BradleyConn/bc_flight_computer/3D_Models/24mm_to_29mm_adapter.stl

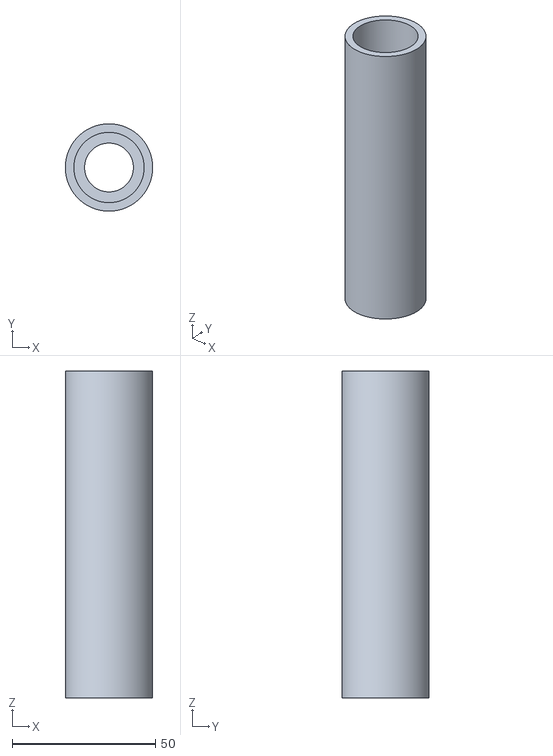
[picture p1: CAD file, 2024-02-27]
3D_Models/24mm_to_29mm_adapter.stl
30.4 x 30.4 x 114.0
