BradleyConn/bc_flight_computer/3D_Models/board_monut_board_slot_test.stl

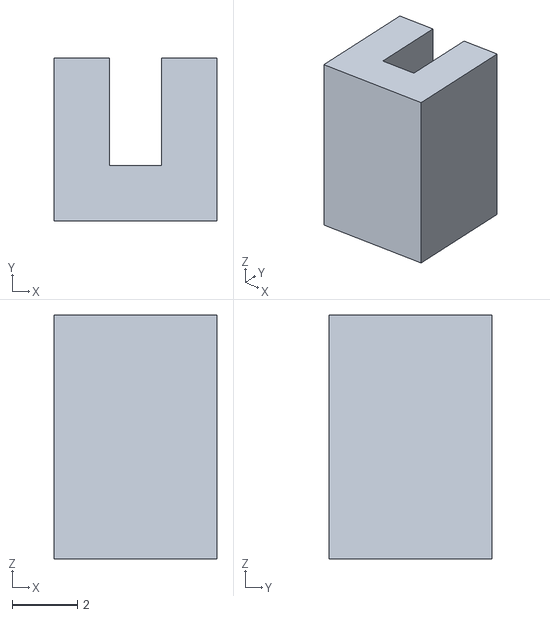
[picture p2: CAD file, 2024-02-27]
3D_Models/board_monut_board_slot_test.stl
5.00 x 5.00 x 7.50
