BradleyConn/bc_flight_computer/Hardware/KiCad/projects/rp2040_v0/rp2040_v0/gerbers_v0.pdf

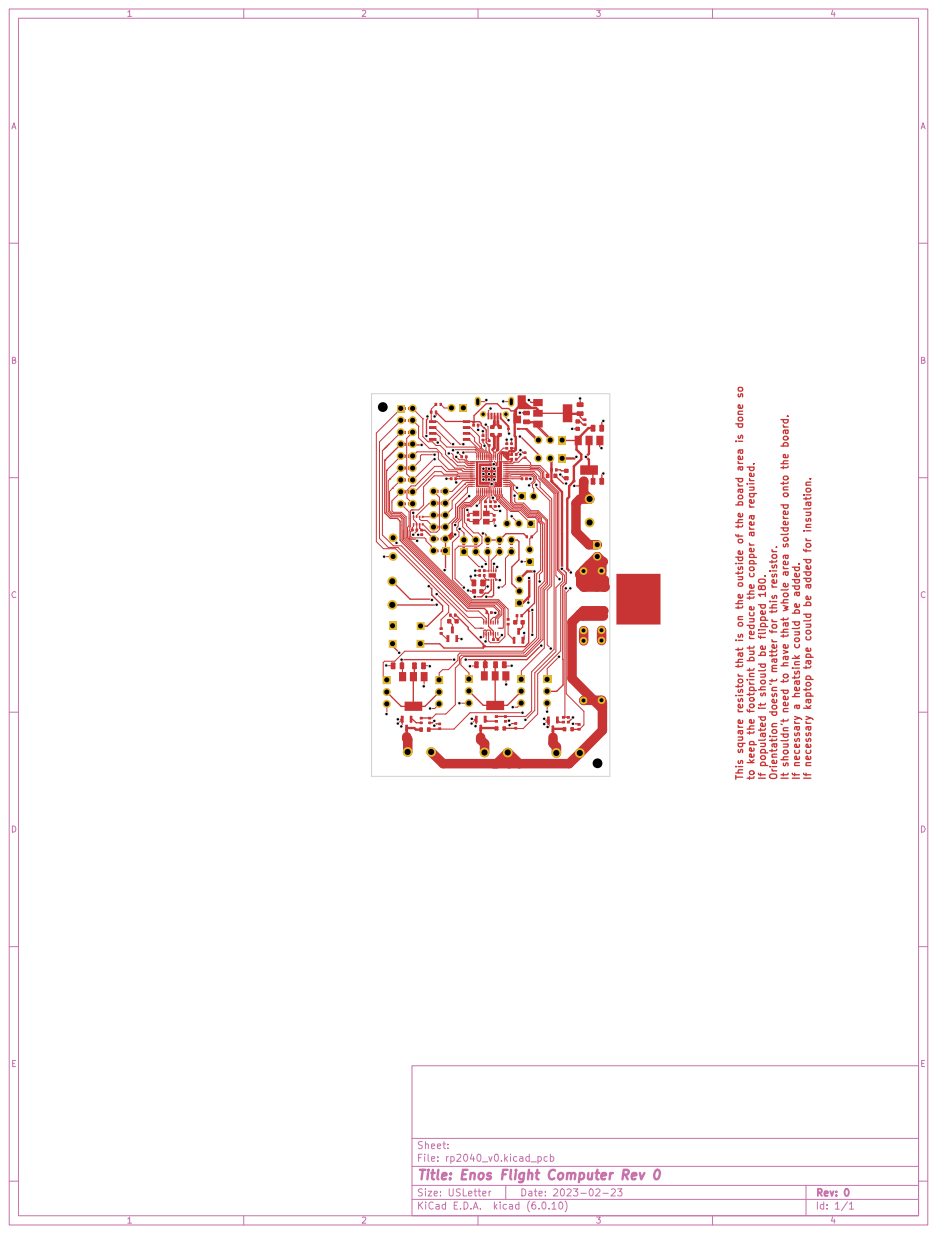
[picture p3: page 1]

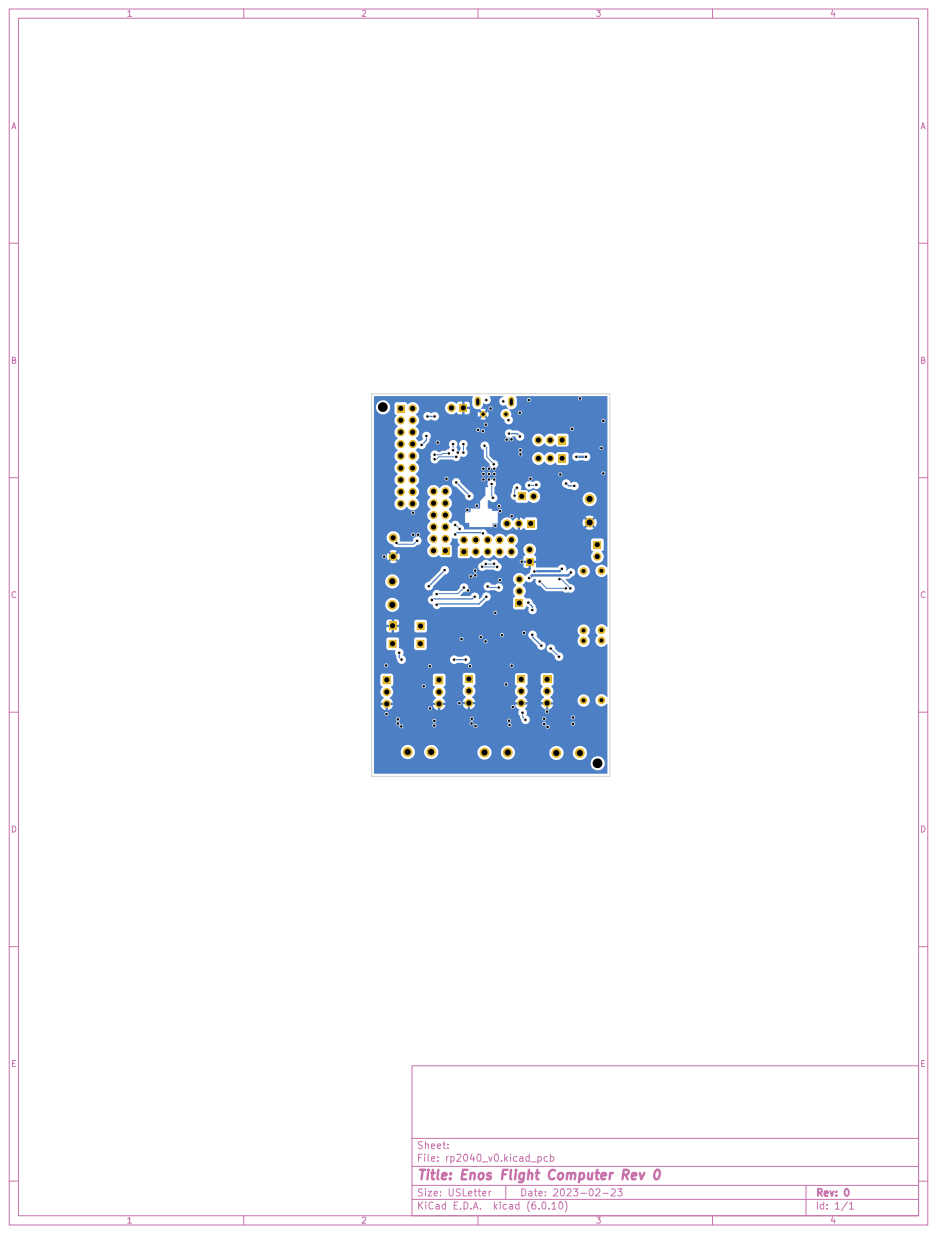
[picture p4: page 2]

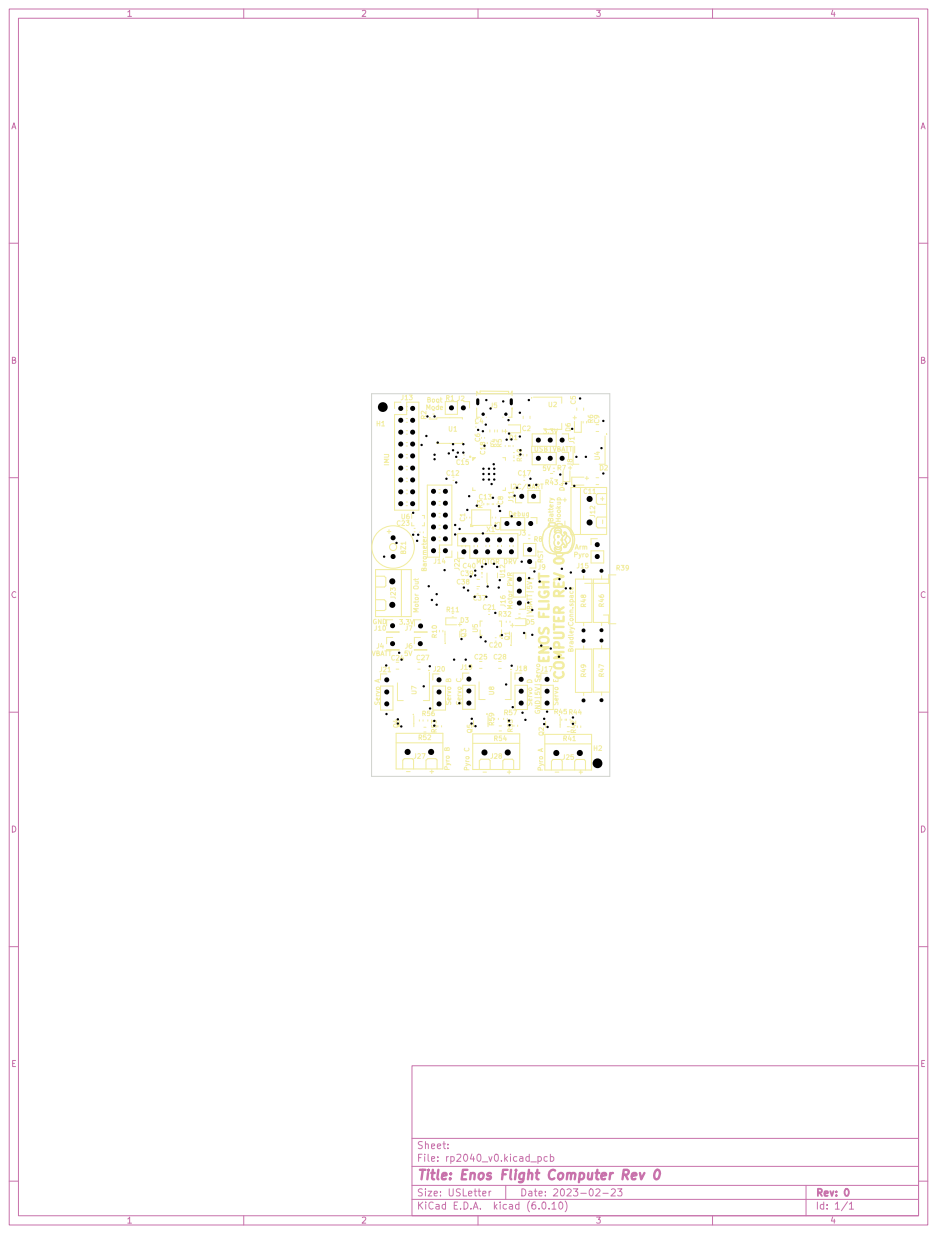
[picture p5: page 3]

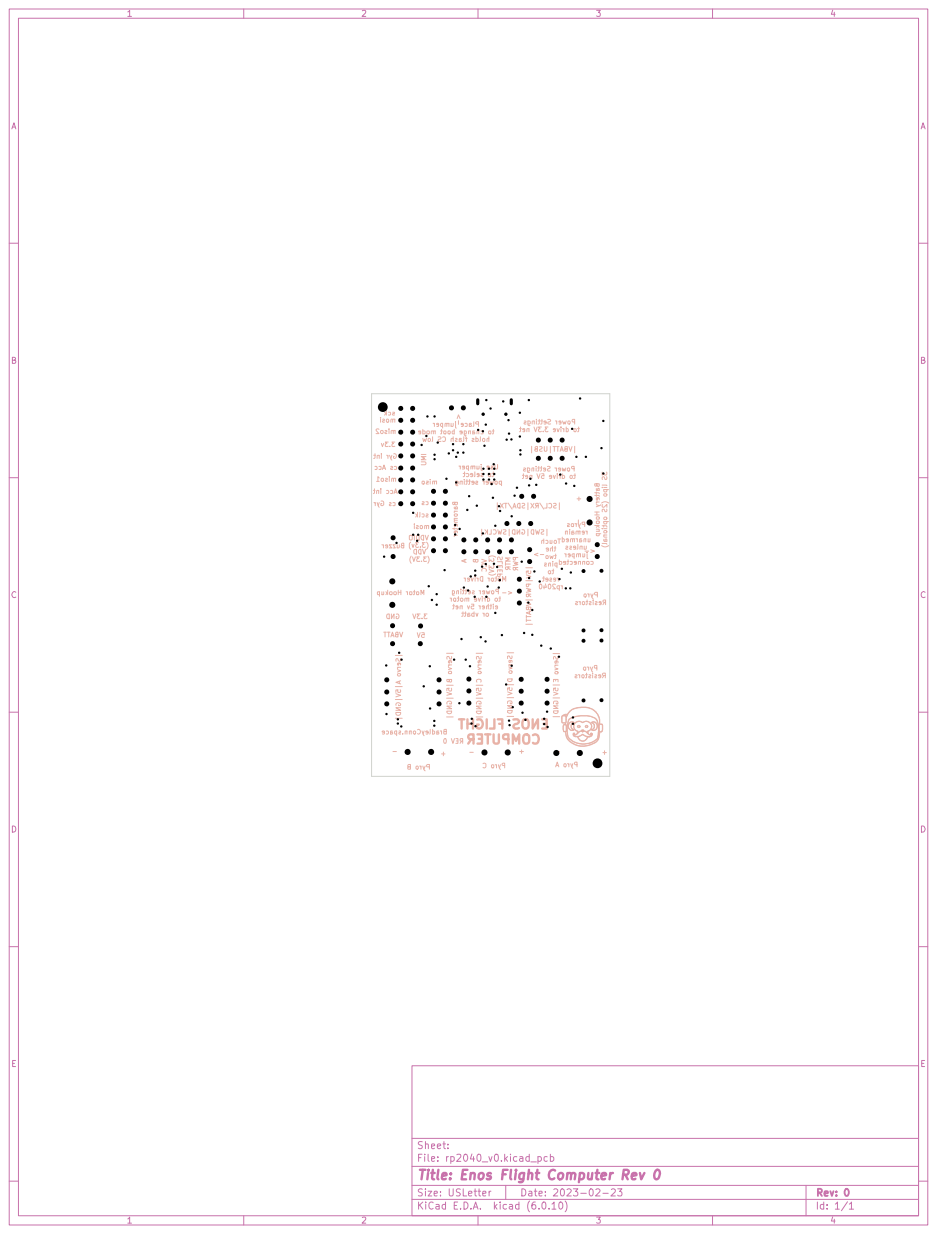
[picture p6: page 4]
