BradleyConn/bc_flight_computer/Hardware/KiCad/projects/rp2040_v0/rp2040_v0/gerbers_v0_single_page.pdf

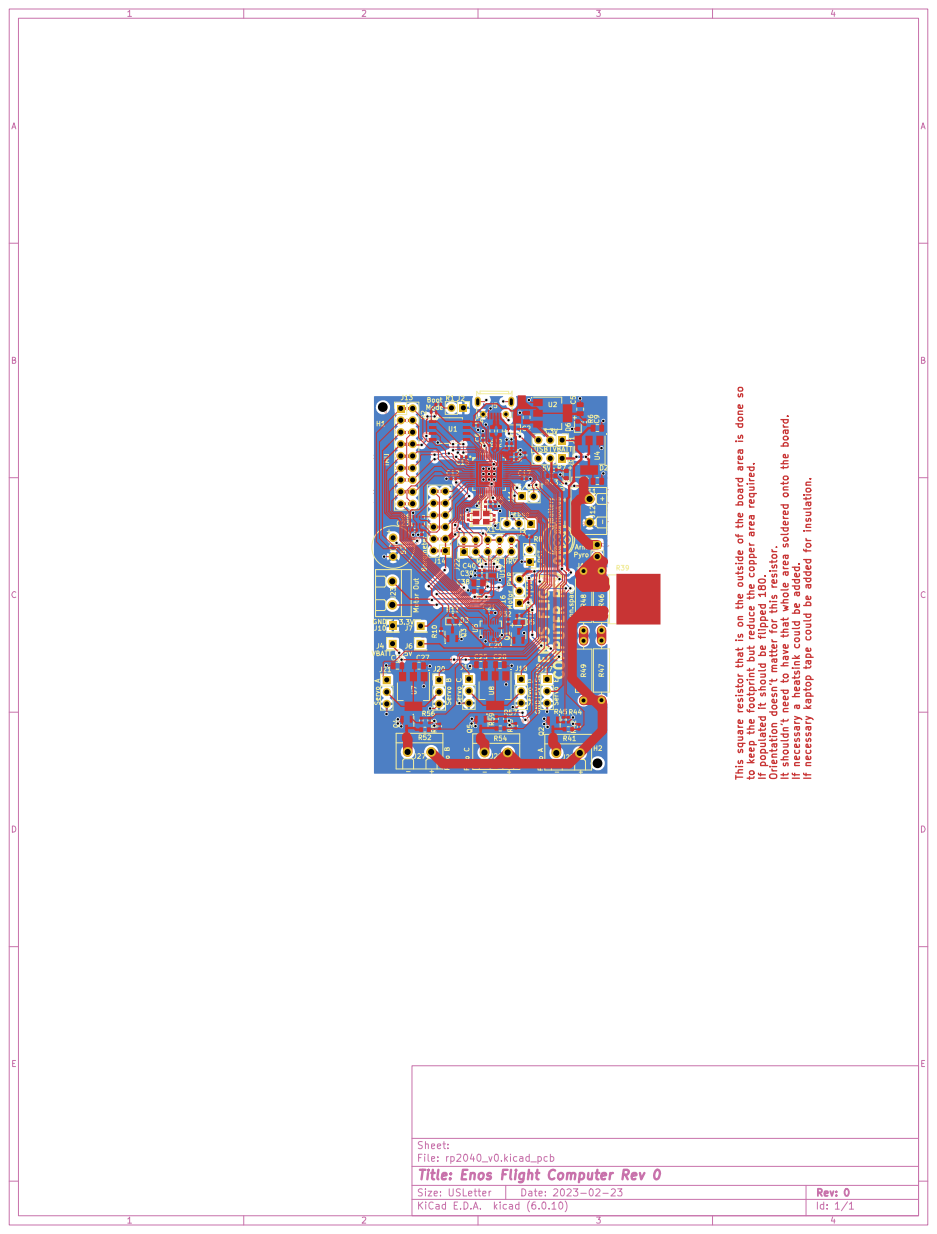
[picture p7: page 1]
