BradleyConn/bc_flight_computer/Hardware/KiCad/projects/rp2040_v0/rp2040_v0/rp2040_v0.kicad_pcb

## KiCad design Hardware/KiCad/projects/rp2040_v0/rp2040_v0/rp2040_v0.kicad_pcb (2024-02-27)

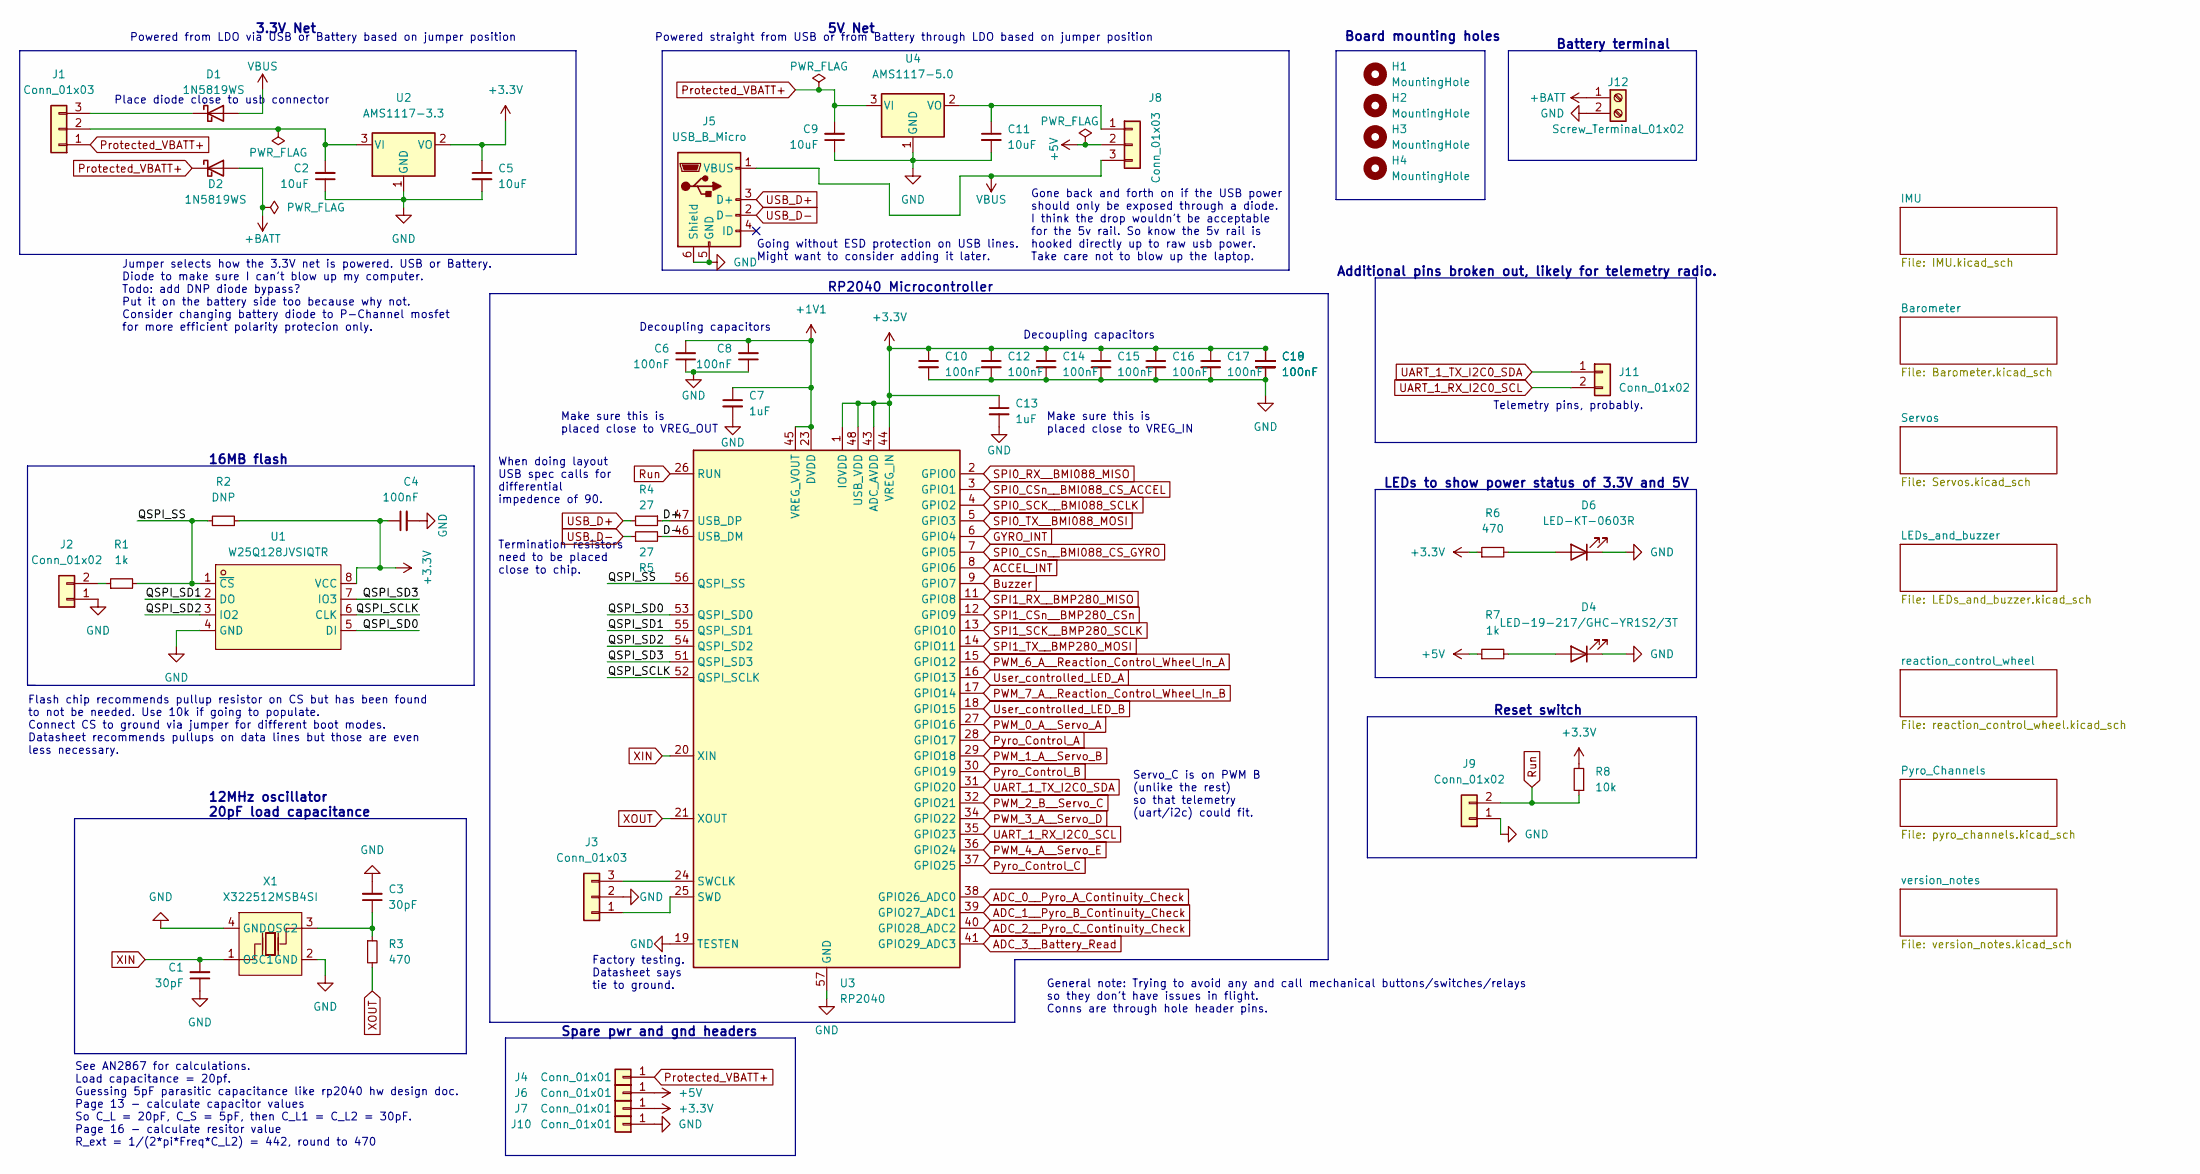
[picture p16: schematic rp2040_v0.kicad_sch, rp2040 Flight Computer]

Parts:
C1, C3: 30pF; C_0402_1005Metric; LCSC Part C1570
C2, C5, C9, C11: 10uF; C_0805_2012Metric; LCSC Part C15850
C4, C6, C8, C10, C12, C14, C15, C16, C17, C18, C19: 100nF; C_0402_1005Metric; LCSC Part C307331
C7, C13: 1uF; C_0402_1005Metric; LCSC Part C52923
D1, D2: 1N5819WS; D_SOD-323; LCSC Part C191023
D4: LED-19-217/GHC-YR1S2/3T; LED_0603_1608Metric; LCSC Part C72043
D6: LED-KT-0603R; LED_0603_1608Metric; LCSC Part C2286
H1, H2, H3, H4: MountingHole; MountingHole_2mm
J1, J3, J8: Conn_01x03; PinHeader_1x03_P2.54mm_Vertical
J2, J9, J11: Conn_01x02; PinHeader_1x02_P2.54mm_Vertical
J4, J6, J7, J10: Conn_01x01; PinHeader_1x01_P2.54mm_Vertical
J5: USB_B_Micro; MICRO-USB-SMD_MICROXNJ; LCSC Part C404969
J12: Screw_Terminal_01x02; CONN-TH_XY301V-A-5.0-2P; JLC Part Extended Part
R1, R7: 1k; R_0402_1005Metric; LCSC Part C11702
R2: DNP; R_0402_1005Metric
R3, R6: 470; R_0402_1005Metric; LCSC Part C25117
R4, R5: 27; R_0603_1608Metric; LCSC Part C25190
R8: 10k; R_0402_1005Metric; LCSC Part C25744
U1: W25Q128JVSIQTR; SOIC-8_5.23x5.23mm_P1.27mm; LCSC Part C97521
U2: AMS1117-3.3; SOT-223-3_TabPin2; LCSC Part C6186
U3: RP2040; LQFN-56_L7.0-W7.0-P0.4-EP; JLC Part Extended Part
U4: AMS1117-5.0; SOT-223-3_TabPin2; LCSC Part C6187
X1: X322512MSB4SI; OSC-SMD_4P-L3.2-W2.5-BL; LCSC Part C9002

Connections:
+1V1: C6.2, C7.1, C8.2, U3.23 (DVDD), U3.45 (VREG_VOUT), U3.50 (DVDD)
+3.3V: C4.1, C5.1, C10.1, C12.1, C13.1, C14.1, C15.1, C16.1, C17.1, C18.1, C19.1, J7.1, R2.2, R6.1, R8.2, U1.8 (VCC), U2.2 (VO), U3.1 (IOVDD), U3.10 (IOVDD), U3.22 (IOVDD), U3.33 (IOVDD), U3.42 (IOVDD), U3.43 (ADC_AVDD), U3.44 (VREG_IN), U3.48 (USB_VDD), U3.49 (IOVDD); also elsewhere on the board
+5V: J6.1, J8.2, R7.1; also elsewhere on the board
+BATT: D2.2 (A), J12.1; also elsewhere on the board
/D+: R4.1, U3.47 (USB_DP)
/D-: R5.2, U3.46 (USB_DM)
/QSPI_SCLK: U1.6 (CLK), U3.52 (QSPI_SCLK)
/QSPI_SD0: U1.5 (DI), U3.53 (QSPI_SD0)
/QSPI_SD1: U1.2 (DO), U3.55 (QSPI_SD1)
/QSPI_SD2: U1.3 (IO2), U3.54 (QSPI_SD2)
/QSPI_SD3: U1.7 (IO3), U3.51 (QSPI_SD3)
/QSPI_SS: R1.2, R2.1, U1.1 (~CS), U3.56 (QSPI_SS)
ACCEL_INT: U3.8 (GPIO6); also elsewhere on the board
ADC_0__Pyro_A_Continuity_Check: U3.38 (GPIO26_ADC0); also elsewhere on the board
ADC_1__Pyro_B_Continuity_Check: U3.39 (GPIO27_ADC1); also elsewhere on the board
ADC_2__Pyro_C_Continuity_Check: U3.40 (GPIO28_ADC2); also elsewhere on the board
ADC_3__Battery_Read: U3.41 (GPIO29_ADC3); also elsewhere on the board
Buzzer: U3.9 (GPIO7); also elsewhere on the board
GND: C1.1, C2.1, C3.2, C4.2, C5.2, C6.1, C7.2, C8.1, C9.1, C10.2, C11.2, C12.2, C13.2, C14.2, C15.2, C16.2, C17.2, C18.2, C19.2, D4.1 (K), D6.1 (K), J2.1, J3.2, J5.5 (GND), J5.6 (Shield), J9.1, J10.1, J12.2, U1.4 (GND), U2.1 (GND), U3.19 (TESTEN), U3.57 (GND), U4.1 (GND), X1.2 (GND), X1.4 (GND); also elsewhere on the board
GYRO_INT: U3.6 (GPIO4); also elsewhere on the board
unnamed: C2.2, J1.2, U2.3 (VI)
unnamed: C3.1, R3.1, X1.3 (OSC2)
unnamed: C11.1, J8.1, U4.2 (VO)
unnamed: D1.1 (K), J1.3
unnamed: D4.2 (A), R7.2
unnamed: D6.2 (A), R6.2
unnamed: J2.2, R1.1
unnamed: J3.1, U3.25 (SWD)
unnamed: J3.3, U3.24 (SWCLK)
PWM_0_A__Servo_A: U3.27 (GPIO16); also elsewhere on the board
PWM_1_A__Servo_B: U3.29 (GPIO18); also elsewhere on the board
PWM_2_B__Servo_C: U3.32 (GPIO21); also elsewhere on the board
PWM_3_A__Servo_D: U3.34 (GPIO22); also elsewhere on the board
PWM_4_A__Servo_E: U3.36 (GPIO24); also elsewhere on the board
PWM_6_A__Reaction_Control_Wheel_In_A: U3.15 (GPIO12); also elsewhere on the board
PWM_7_A__Reaction_Control_Wheel_In_B: U3.17 (GPIO14); also elsewhere on the board
Protected_VBATT+: C9.2, D2.1 (K), J1.1, J4.1, U4.3 (VI); also elsewhere on the board
Pyro_Control_A: U3.28 (GPIO17); also elsewhere on the board
Pyro_Control_B: U3.30 (GPIO19); also elsewhere on the board
Pyro_Control_C: U3.37 (GPIO25); also elsewhere on the board
Run: J9.2, R8.1, U3.26 (RUN)
SPI0_CSn__BMI088_CS_ACCEL: U3.3 (GPIO1); also elsewhere on the board
SPI0_CSn__BMI088_CS_GYRO: U3.7 (GPIO5); also elsewhere on the board
SPI0_RX__BMI088_MISO: U3.2 (GPIO0); also elsewhere on the board
SPI0_SCK__BMI088_SCLK: U3.4 (GPIO2); also elsewhere on the board
SPI0_TX__BMI088_MOSI: U3.5 (GPIO3); also elsewhere on the board
SPI1_CSn__BMP280_CSn: U3.12 (GPIO9); also elsewhere on the board
SPI1_RX__BMP280_MISO: U3.11 (GPIO8); also elsewhere on the board
SPI1_SCK__BMP280_SCLK: U3.13 (GPIO10); also elsewhere on the board
SPI1_TX__BMP280_MOSI: U3.14 (GPIO11); also elsewhere on the board
UART_1_RX_I2C0_SCL: J11.2, U3.35 (GPIO23)
UART_1_TX_I2C0_SDA: J11.1, U3.31 (GPIO20)
USB_D+: J5.3 (D+), R4.2
USB_D-: J5.2 (D-), R5.1
User_controlled_LED_A: U3.16 (GPIO13); also elsewhere on the board
User_controlled_LED_B: U3.18 (GPIO15); also elsewhere on the board
VBUS: D1.2 (A), J5.1 (VBUS), J8.3
XIN: C1.2, U3.20 (XIN), X1.1 (OSC1)
XOUT: R3.2, U3.21 (XOUT)

Notes on the sheet:
Jumper selects how the 3.3V net is powered. USB or Battery. Diode to make sure I can't blow up my computer. Todo: add DNP diode bypass? Put it on the battery side too because why not. Consider changing battery diode to P-Channel mosfet for more efficient polarity protecion only.
Termination resistors need to be placed close to chip.
Telemetry pins, probably.
Make sure this is placed close to VREG_OUT
Servo_C is on PWM B (unlike the rest) so that telemetry (uart/i2c) could fit.
Flash chip recommends pullup resistor on CS but has been found to not be needed. Use 10k if going to populate. Connect CS to ground via jumper for different boot modes. Datasheet recommends pullups on data lines but those are even less necessary.
Factory testing. Datasheet says tie to ground.
3.3V Net
16MB flash
Board mounting holes
Battery terminal
Additional pins broken out, likely for telemetry radio.
Reset switch
When doing layout USB spec calls for differential impedence of 90.
Make sure this is placed close to VREG_IN
Gone back and forth on if the USB power should only be exposed through a diode. I think the drop wouldn't be acceptable for the 5v rail. So know the 5v rail is hooked directly up to raw usb power. Take care not to blow up the laptop.
Place diode close to usb connector
See AN2867 for calculations. Load capacitance = 20pf. Guessing 5pF parasitic capacitance like rp2040 hw design doc. Page 13 - calculate capacitor values So C_L = 20pF, C_S = 5pF, then C_L1 = C_L2 = 30pF. Page 16 - calculate resitor value R_ext = 1/(2*pi*Freq*C_L2) = 442, round to 470
5V Net
Going without ESD protection on USB lines. Might want to consider adding it later.
RP2040 Microcontroller
General note: Trying to avoid any and call mechanical buttons/switches/relays so they don't have issues in flight. Conns are through hole header pins.
Spare pwr and gnd headers
Powered straight from USB or from Battery through LDO based on jumper position
Decoupling capacitors
Powered from LDO via USB or Battery based on jumper position
12MHz oscillator 20pF load capacitance
LEDs to show power status of 3.3V and 5V

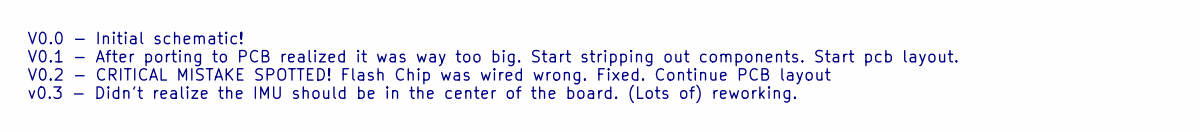
[picture p17: schematic version_notes.kicad_sch, Version notes!]

Notes on the sheet:
V0.0 - Initial schematic! V0.1 - After porting to PCB realized it was way too big. Start stripping out components. Start pcb layout. V0.2 - CRITICAL MISTAKE SPOTTED! Flash Chip was wired wrong. Fixed. Continue PCB layout v0.3 - Didn't realize the IMU should be in the center of the board. (Lots of) 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

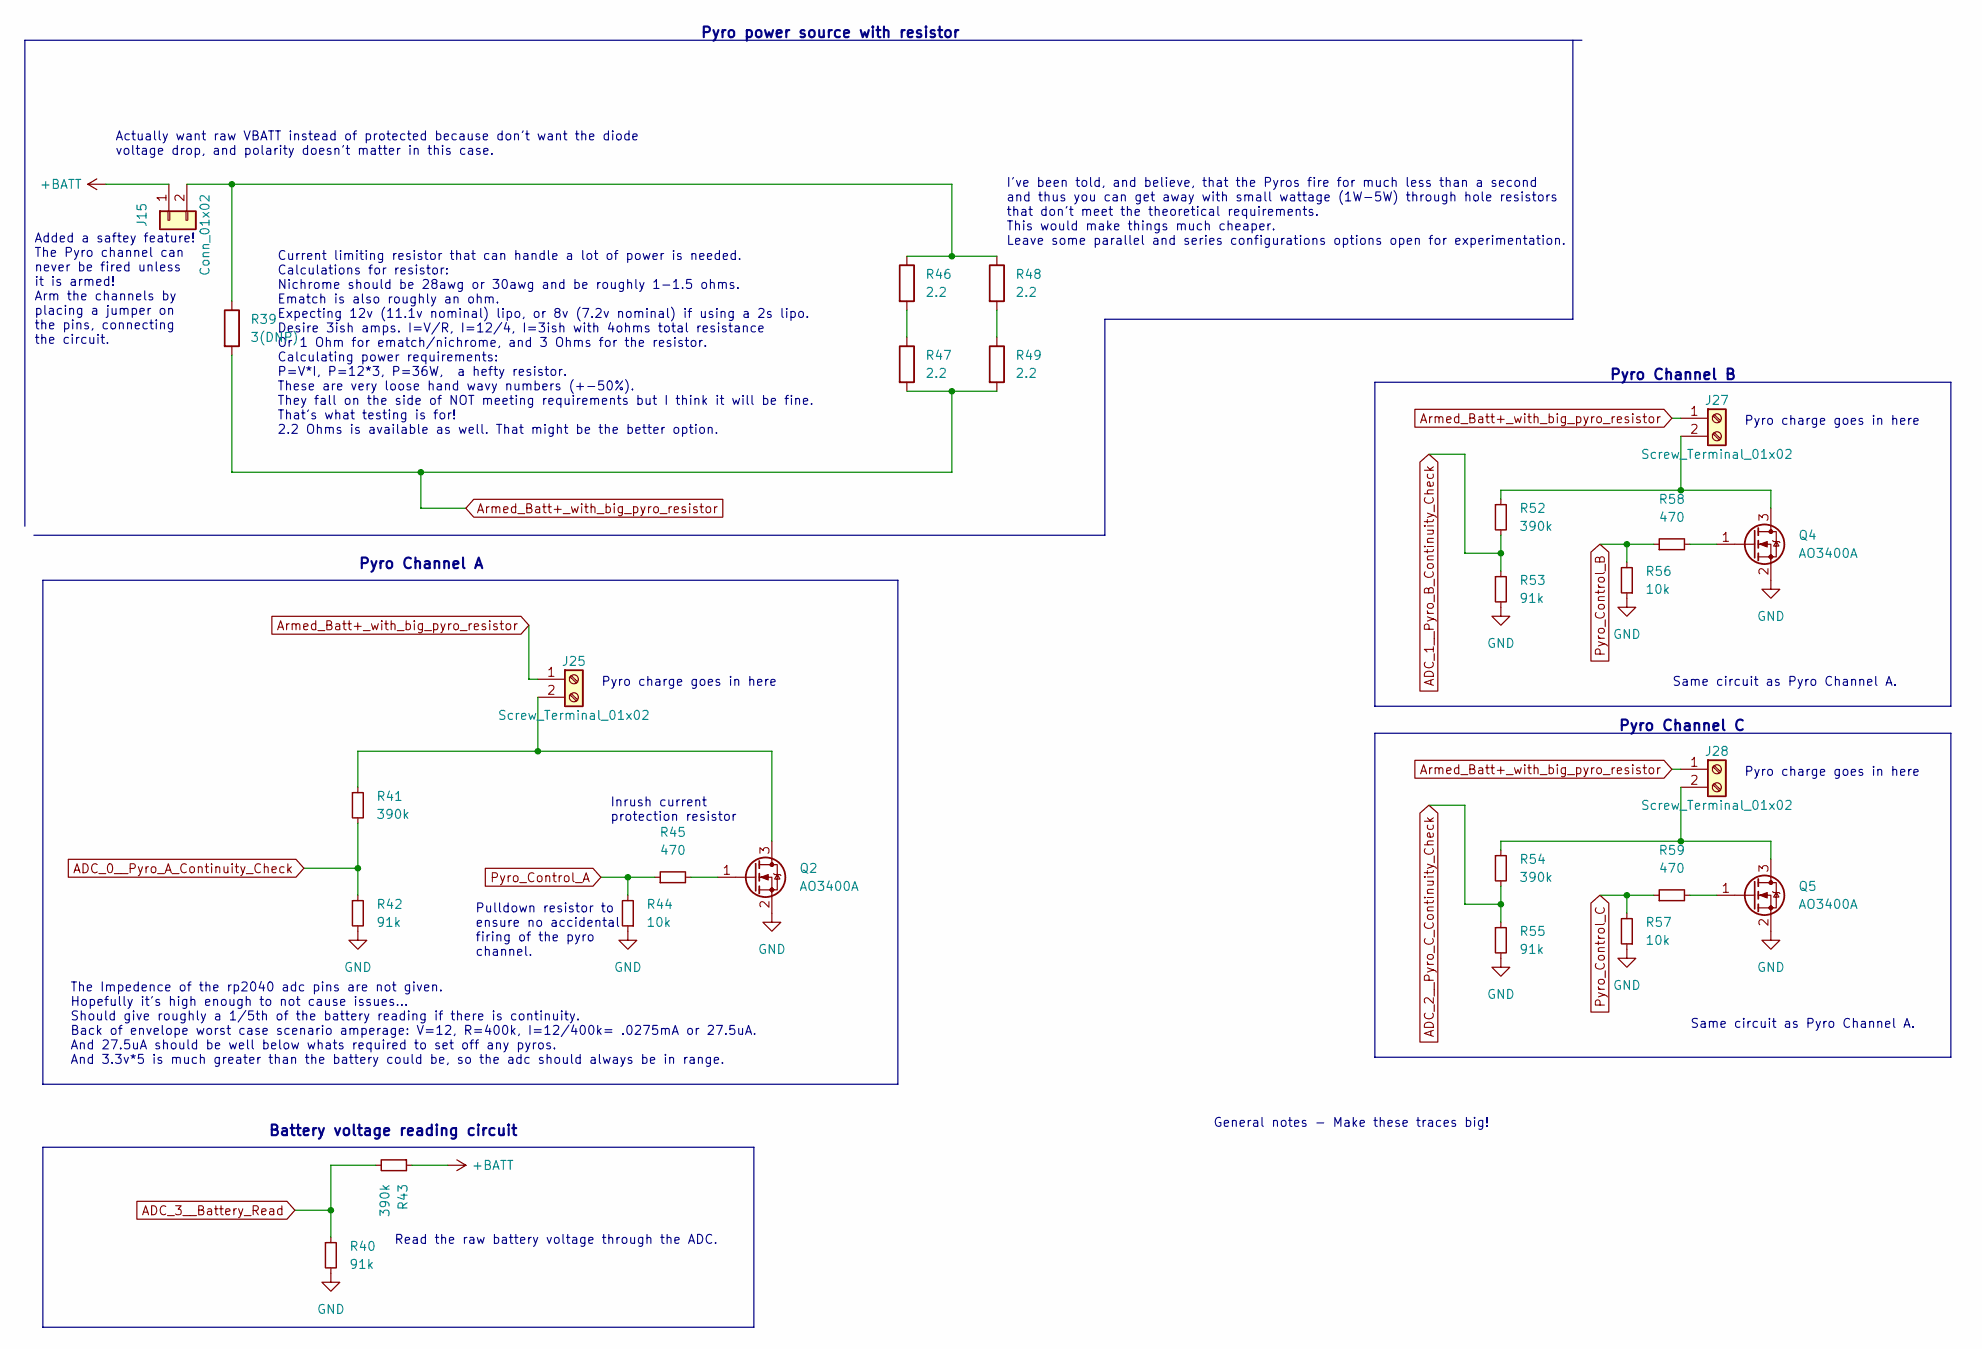
[picture p18: schematic pyro_channels.kicad_sch, Pyros!]

Parts:
J15: Conn_01x02; PinHeader_1x02_P2.54mm_Vertical
J25, J27, J28: Screw_Terminal_01x02; CONN-TH_XY301V-A-5.0-2P; JLC Part Extended Part
Q2, Q4, Q5: AO3400A; SOT-23; LCSC Part C20917
R39: 3(DNP); TO-263-2_TabPin1
R40, R42, R53, R55: 91k; R_0402_1005Metric; LCSC Part C25741
R41, R43, R52, R54: 390k; R_0603_1608Metric; LCSC Part C23150
R44, R56, R57: 10k; R_0402_1005Metric; LCSC Part C25744
R45, R58, R59: 470; R_0402_1005Metric; LCSC Part C25117
R46, R47, R48, R49: 2.2; R_Axial_DIN0309_L9.0mm_D3.2mm_P12.70mm_Horizontal; JLC Part Basic Part

Connections:
+BATT: J15.1, R43.1; also elsewhere on the board
ADC_0__Pyro_A_Continuity_Check: R41.2, R42.1; also elsewhere on the board
ADC_1__Pyro_B_Continuity_Check: R52.2, R53.1; also elsewhere on the board
ADC_2__Pyro_C_Continuity_Check: R54.2, R55.1; also elsewhere on the board
ADC_3__Battery_Read: R40.1, R43.2; also elsewhere on the board
Armed_Batt+_with_big_pyro_resistor: J25.1, J27.1, J28.1, R39.2, R47.2, R49.2
GND: Q2.2 (S), Q4.2 (S), Q5.2 (S), R40.2, R42.2, R44.1, R53.2, R55.2, R56.1, R57.1; also elsewhere on the board
unnamed: J15.2, R39.1, R46.1, R48.1
unnamed: J25.2, Q2.3 (D), R41.1
unnamed: J27.2, Q4.3 (D), R52.1
unnamed: J28.2, Q5.3 (D), R54.1
unnamed: Q2.1 (G), R45.2
unnamed: Q4.1 (G), R58.2
unnamed: Q5.1 (G), R59.2
unnamed: R46.2, R47.1
unnamed: R48.2, R49.1
Pyro_Control_A: R44.2, R45.1; also elsewhere on the board
Pyro_Control_B: R56.2, R58.1; also elsewhere on the board
Pyro_Control_C: R57.2, R59.1; also elsewhere on the board

Notes on the sheet:
Current limiting resistor that can handle a lot of power is needed. Calculations for resistor: Nichrome should be 28awg or 30awg and be roughly 1-1.5 ohms. Ematch is also roughly an ohm. Expecting 12v (11.1v nominal) lipo, or 8v (7.2v nominal) if using a 2s lipo. Desire 3ish amps. I=V/R, I=12/4, I=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
Added a saftey feature! The Pyro channel can never be fired unless it is armed! Arm the channels by placing a jumper on the pins, connecting the circuit.
Pyro Channel A
Pyro Channel C
Pyro charge goes in here
Pyro Channel B
The Impedence of the rp2040 adc pins are not given. Hopefully it's high enough to not cause issues... Should give roughly a 1/5th of the battery reading if there is continuity. Back of envelope worst case scenario amperage: V=12, R=400k, I=12/400k= .0275mA or 27.5uA. And 27.5uA should be well below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
Inrush current protection resistor
Actually want raw VBATT instead of protected because don't want the diode voltage drop, and polarity doesn't matter in this case.
Battery voltage reading circuit
Pyro power source with resistor
Same circuit as Pyro Channel A.
Read the raw battery voltage through the ADC.
I've been told, and believe, that the Pyros fire for much less than a second and thus you can get away with small wattage (1W-5W) through hole resistors that don't meet the theoretical requirements. This would make things much cheaper. Leave some parallel and series configurations options open for 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
General notes - Make these traces big!
Pulldown resistor to ensure no accidental firing of the pyro channel.

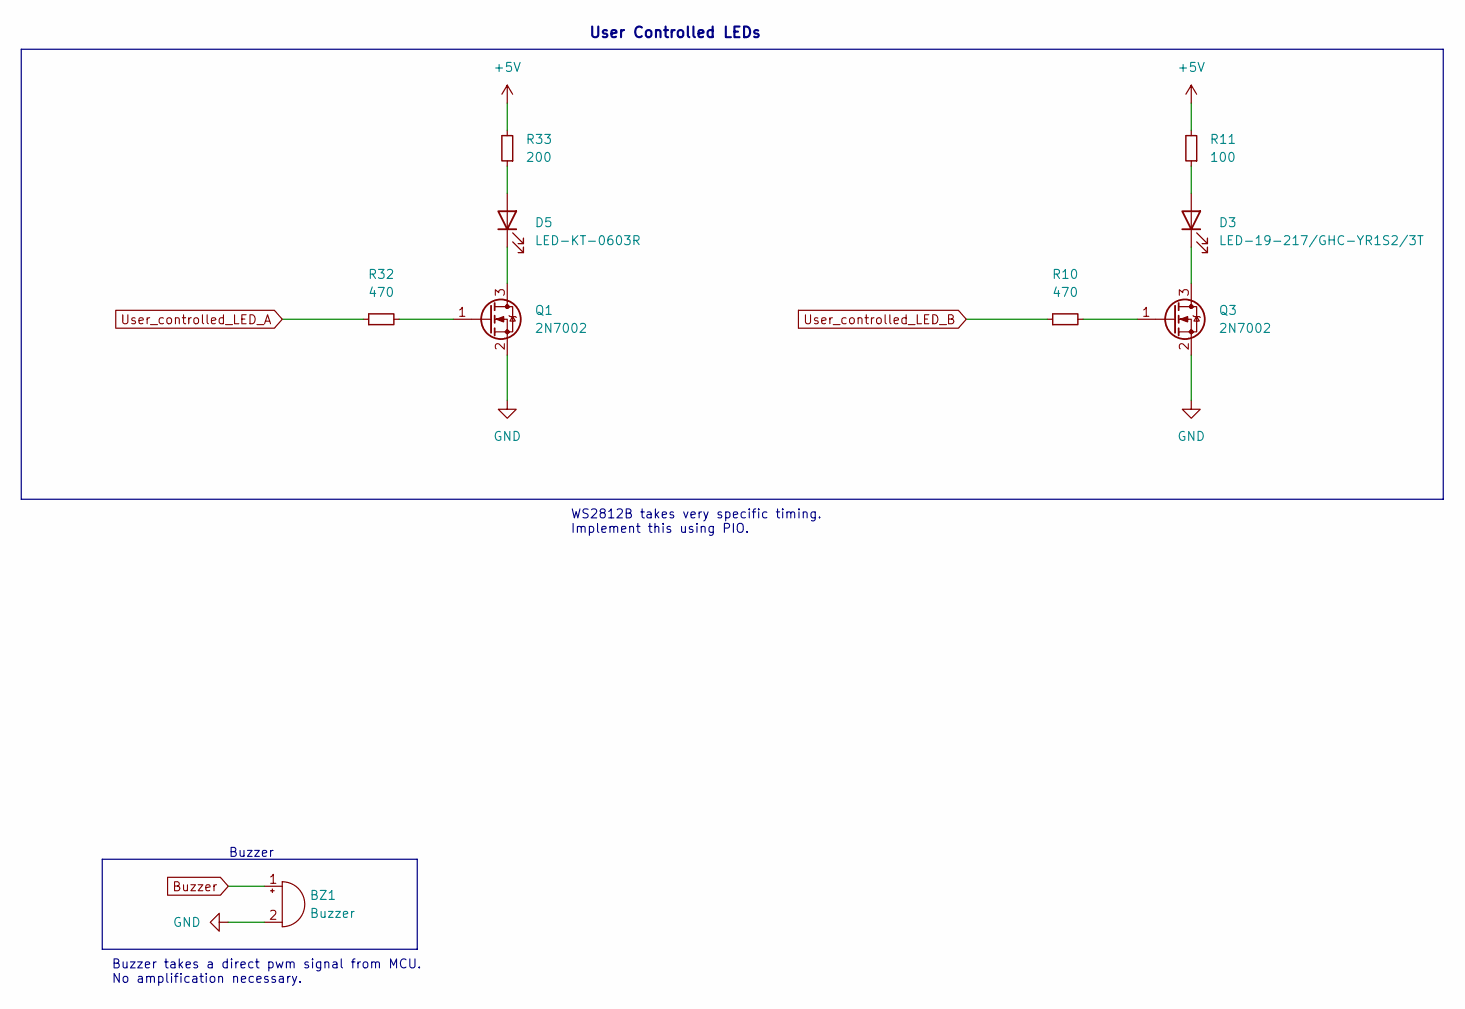
[picture p19: schematic LEDs_and_buzzer.kicad_sch, User Controlled LEDs and Buzzer]

Parts:
BZ1: Buzzer; BUZ-TH_BD9.0-P4.00-D0.6-FD; LCSC Part C161819
D3: LED-19-217/GHC-YR1S2/3T; LED_0603_1608Metric; LCSC Part C72043
D5: LED-KT-0603R; LED_0603_1608Metric; LCSC Part C2286
Q1, Q3: 2N7002; SOT-23; LCSC Part C8545
R10, R32: 470; R_0402_1005Metric; LCSC Part C25117
R11: 100; R_0402_1005Metric; LCSC Part C25076
R33: 200; R_0402_1005Metric; LCSC Part C25087

Connections:
+5V: R11.2, R33.2; also elsewhere on the board
Buzzer: BZ1.1 (-); also elsewhere on the board
GND: BZ1.2 (+), Q1.2 (S), Q3.2 (S); also elsewhere on the board
unnamed: D3.1 (K), Q3.3 (D)
unnamed: D3.2 (A), R11.1
unnamed: D5.1 (K), Q1.3 (D)
unnamed: D5.2 (A), R33.1
unnamed: Q1.1 (G), R32.2
unnamed: Q3.1 (G), R10.2
User_controlled_LED_A: R32.1; also elsewhere on the board
User_controlled_LED_B: R10.1; also elsewhere on the board

Notes on the sheet:
Buzzer takes a direct pwm signal from MCU. No amplification necessary.
WS2812B takes very specific timing. Implement this using PIO.
Buzzer
User Controlled LEDs

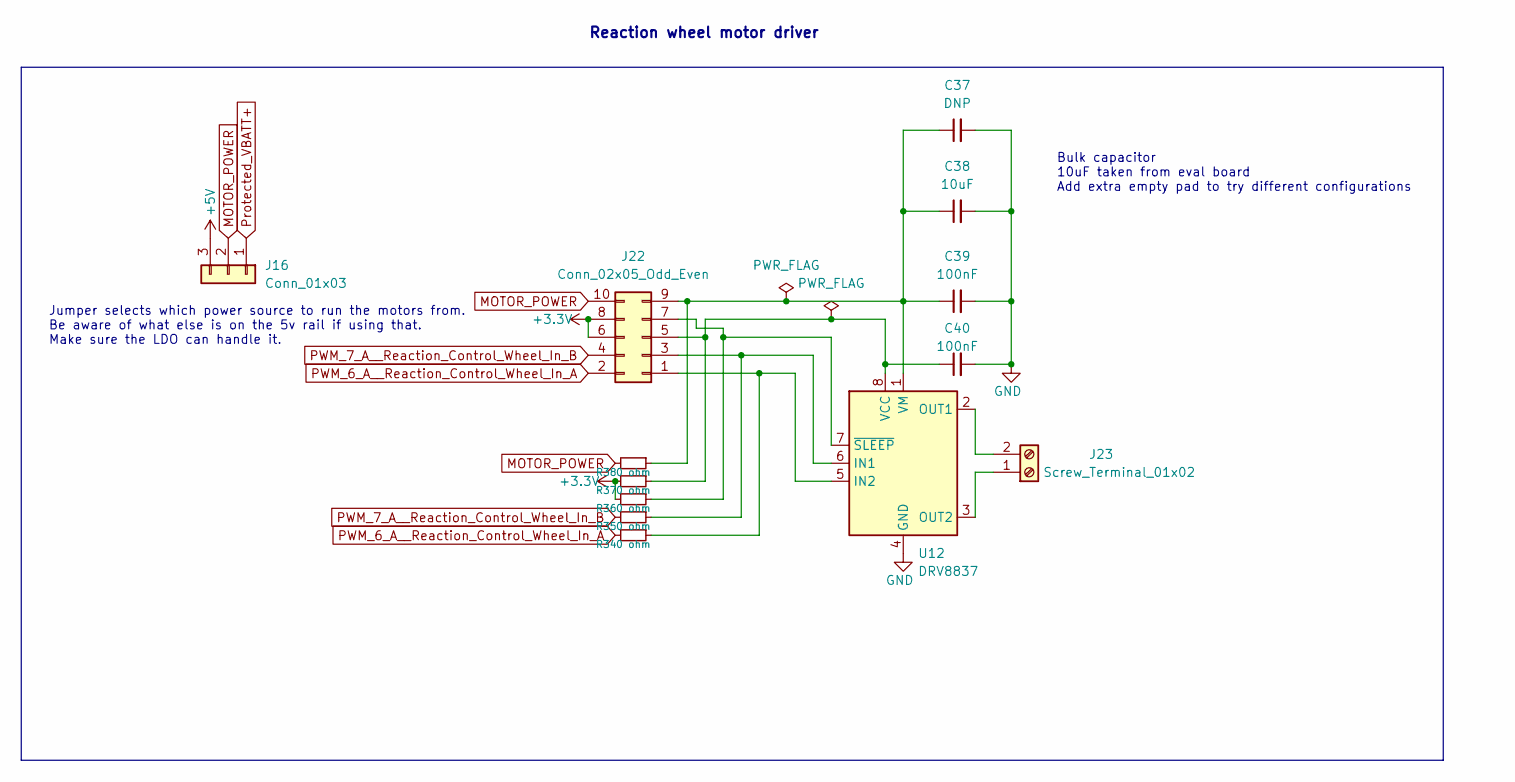
[picture p20: schematic reaction_control_wheel.kicad_sch, Reaction Control Wheel]

Parts:
C37: DNP; C_0603_1608Metric
C38: 10uF; C_0805_2012Metric; LCSC Part C15850
C39, C40: 100nF; C_0402_1005Metric; LCSC Part C307331
J16: Conn_01x03; PinHeader_1x03_P2.54mm_Vertical
J22: Conn_02x05_Odd_Even; PinHeader_2x05_P2.54mm_Vertical
J23: Screw_Terminal_01x02; CONN-TH_XY301V-A-5.0-2P; JLC Part Extended Part
R34, R35, R36, R37, R38: 0 ohm; R_0402_1005Metric; LCSC Part C17168
U12: DRV8837; WSON-8-1EP_2x2mm_P0.5mm_EP0.9x1.6mm; LCSC Part C39159

Connections:
+3.3V: J22.6, J22.8, R36.2, R37.2; also elsewhere on the board
+5V: J16.3; also elsewhere on the board
GND: C37.2, C38.2, C39.2, C40.2, U12.4 (GND), U12.9 (GND); also elsewhere on the board
MOTOR_POWER: J16.2, J22.10, R38.2
unnamed: C37.1, C38.1, C39.1, J22.9, R38.1, U12.1 (VM)
unnamed: C40.1, J22.5, R37.1, U12.8 (VCC)
unnamed: J22.1, R34.1, U12.5 (IN2)
unnamed: J22.3, R35.1, U12.6 (IN1)
unnamed: J22.7, R36.1, U12.7 (~SLEEP)
unnamed: J23.1, U12.3 (OUT2)
unnamed: J23.2, U12.2 (OUT1)
PWM_6_A__Reaction_Control_Wheel_In_A: J22.2, R34.2; also elsewhere on the board
PWM_7_A__Reaction_Control_Wheel_In_B: J22.4, R35.2; also elsewhere on the board
Protected_VBATT+: J16.1; also elsewhere on the board

Notes on the sheet:
Reaction wheel motor driver
Bulk capacitor 10uF taken from eval board Add extra empty pad to try different configurations
Jumper selects which power source to run the motors from. Be aware of what else is on the 5v rail if using that. Make sure the LDO can handle it.

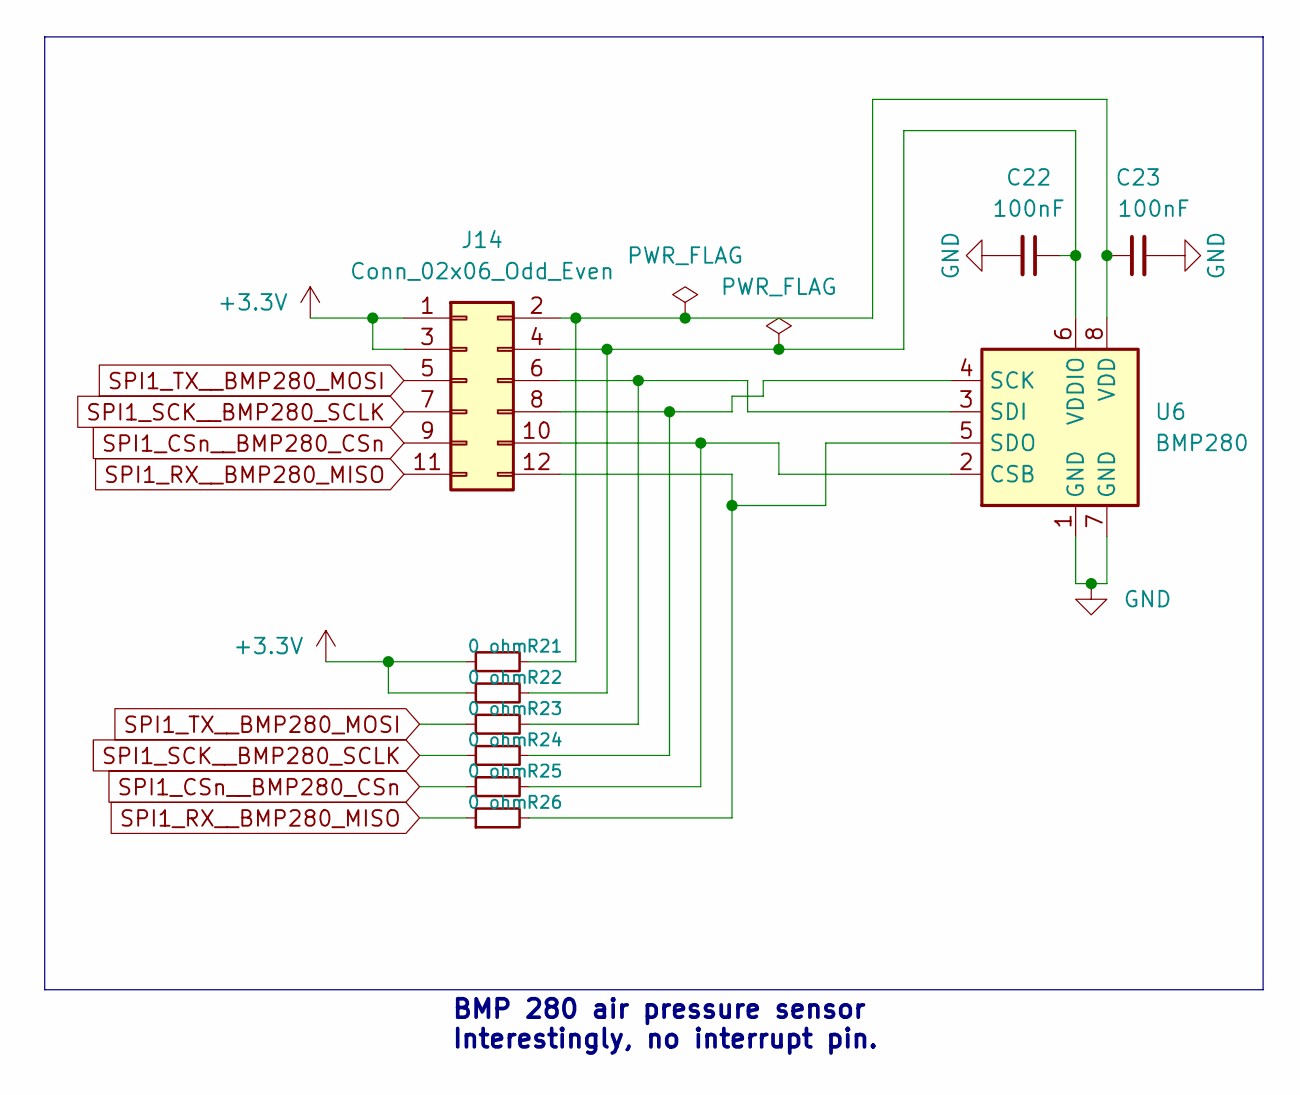
[picture p21: schematic Barometer.kicad_sch]

Parts:
C22, C23: 100nF; C_0402_1005Metric; LCSC Part C307331
J14: Conn_02x06_Odd_Even; PinHeader_2x06_P2.54mm_Vertical
R21, R22, R23, R24, R25, R26: 0 ohm; R_0402_1005Metric; LCSC Part C17168
U6: BMP280; Bosch_LGA-8_2x2.5mm_P0.65mm_ClockwisePinNumbering; LCSC Part C83291

Connections:
+3.3V: J14.1, J14.3, R21.1, R22.1; also elsewhere on the board
GND: C22.2, C23.2, U6.1 (GND), U6.7 (GND); also elsewhere on the board
unnamed: C22.1, J14.4, R22.2, U6.6 (VDDIO)
unnamed: C23.1, J14.2, R21.2, U6.8 (VDD)
unnamed: J14.6, R23.2, U6.3 (SDI)
unnamed: J14.8, R24.2, U6.4 (SCK)
unnamed: J14.10, R25.2, U6.2 (CSB)
unnamed: J14.12, R26.2, U6.5 (SDO)
SPI1_CSn__BMP280_CSn: J14.9, R25.1; also elsewhere on the board
SPI1_RX__BMP280_MISO: J14.11, R26.1; also elsewhere on the board
SPI1_SCK__BMP280_SCLK: J14.7, R24.1; also elsewhere on the board
SPI1_TX__BMP280_MOSI: J14.5, R23.1; also elsewhere on the board

Notes on the sheet:
BMP 280 air pressure sensor Interestingly, no interrupt pin.

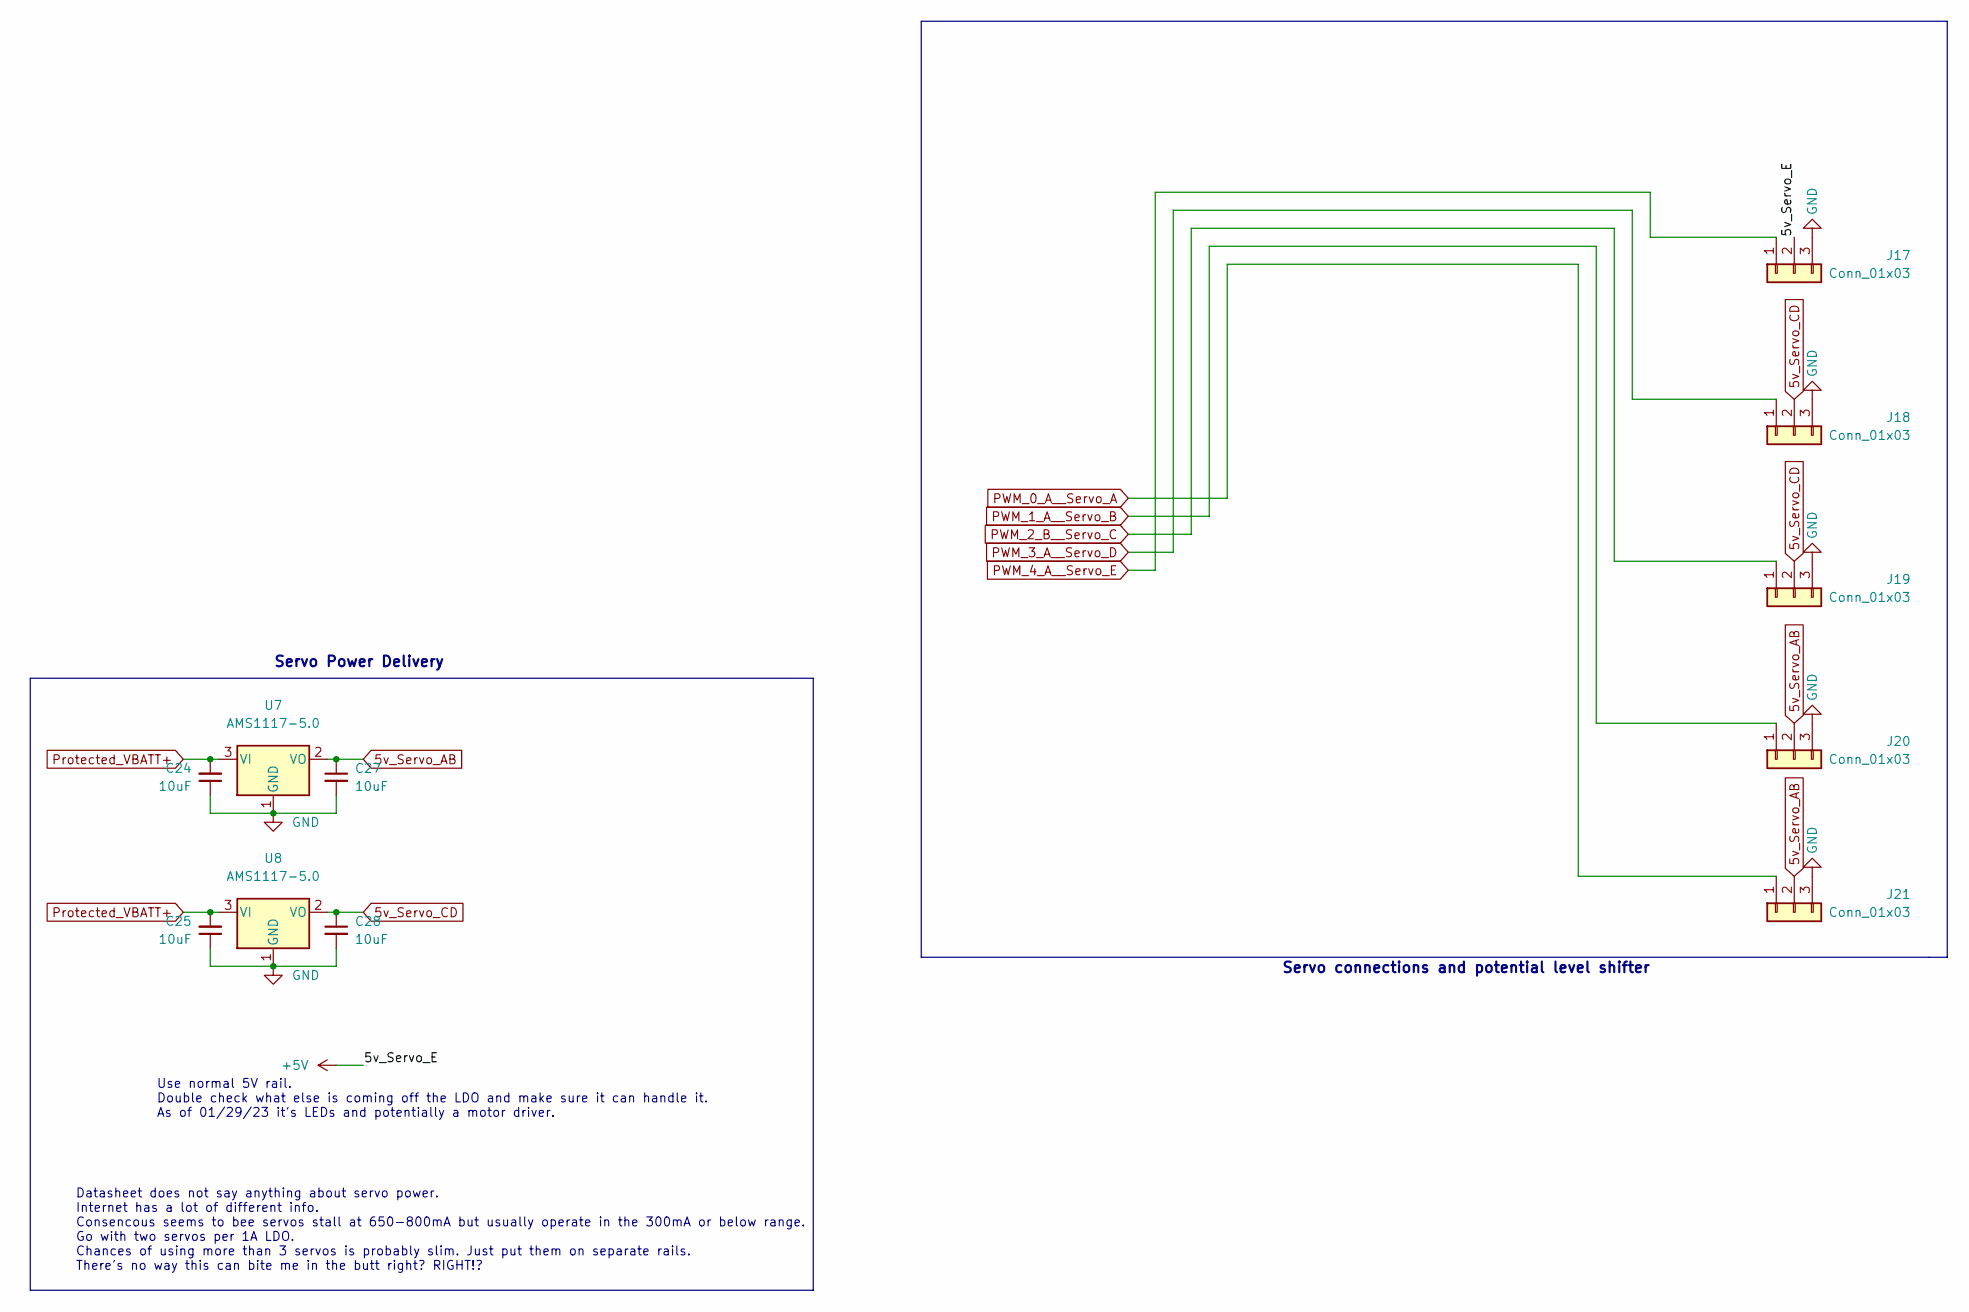
[picture p22: schematic Servos.kicad_sch, Servo Motor Circuitry]

Parts:
C24, C25, C27, C28: 10uF; C_0805_2012Metric; LCSC Part C15850
J17, J18, J19, J20, J21: Conn_01x03; PinHeader_1x03_P2.54mm_Vertical
U7, U8: AMS1117-5.0; SOT-223-3_TabPin2; LCSC Part C6187

Connections:
5v_Servo_AB: C27.1, J20.2, J21.2, U7.2 (VO)
5v_Servo_CD: C28.1, J18.2, J19.2, U8.2 (VO)
+5V: J17.2; also elsewhere on the board
GND: C24.1, C25.1, C27.2, C28.2, J17.3, J18.3, J19.3, J20.3, J21.3, U7.1 (GND), U8.1 (GND); also elsewhere on the board
PWM_0_A__Servo_A: J21.1; also elsewhere on the board
PWM_1_A__Servo_B: J20.1; also elsewhere on the board
PWM_2_B__Servo_C: J19.1; also elsewhere on the board
PWM_3_A__Servo_D: J18.1; also elsewhere on the board
PWM_4_A__Servo_E: J17.1; also elsewhere on the board
Protected_VBATT+: C24.2, C25.2, U7.3 (VI), U8.3 (VI); also elsewhere on the board

Notes on the sheet:
Servo Power Delivery
Datasheet does not say anything about servo power. Internet has a lot of different info. Consencous seems to bee servos stall at 650-800mA but usually operate in the 300mA or below range. Go with two servos per 1A LDO. Chances of using more than 3 servos is probably slim. Just put them on separate 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
Servo connections and potential level shifter
Use normal 5V rail. Double check what else is coming off the LDO and make sure it can handle it. As of 01/29/23 it's LEDs and potentially a motor driver.
