BradleyConn/bc_flight_computer/Hardware/KiCad/projects/rp2040_v0/rp2040_v0/rp2040_v0.kicad_pcb

## KiCad design Hardware/KiCad/projects/rp2040_v0/rp2040_v0/rp2040_v0.kicad_pcb (continued)

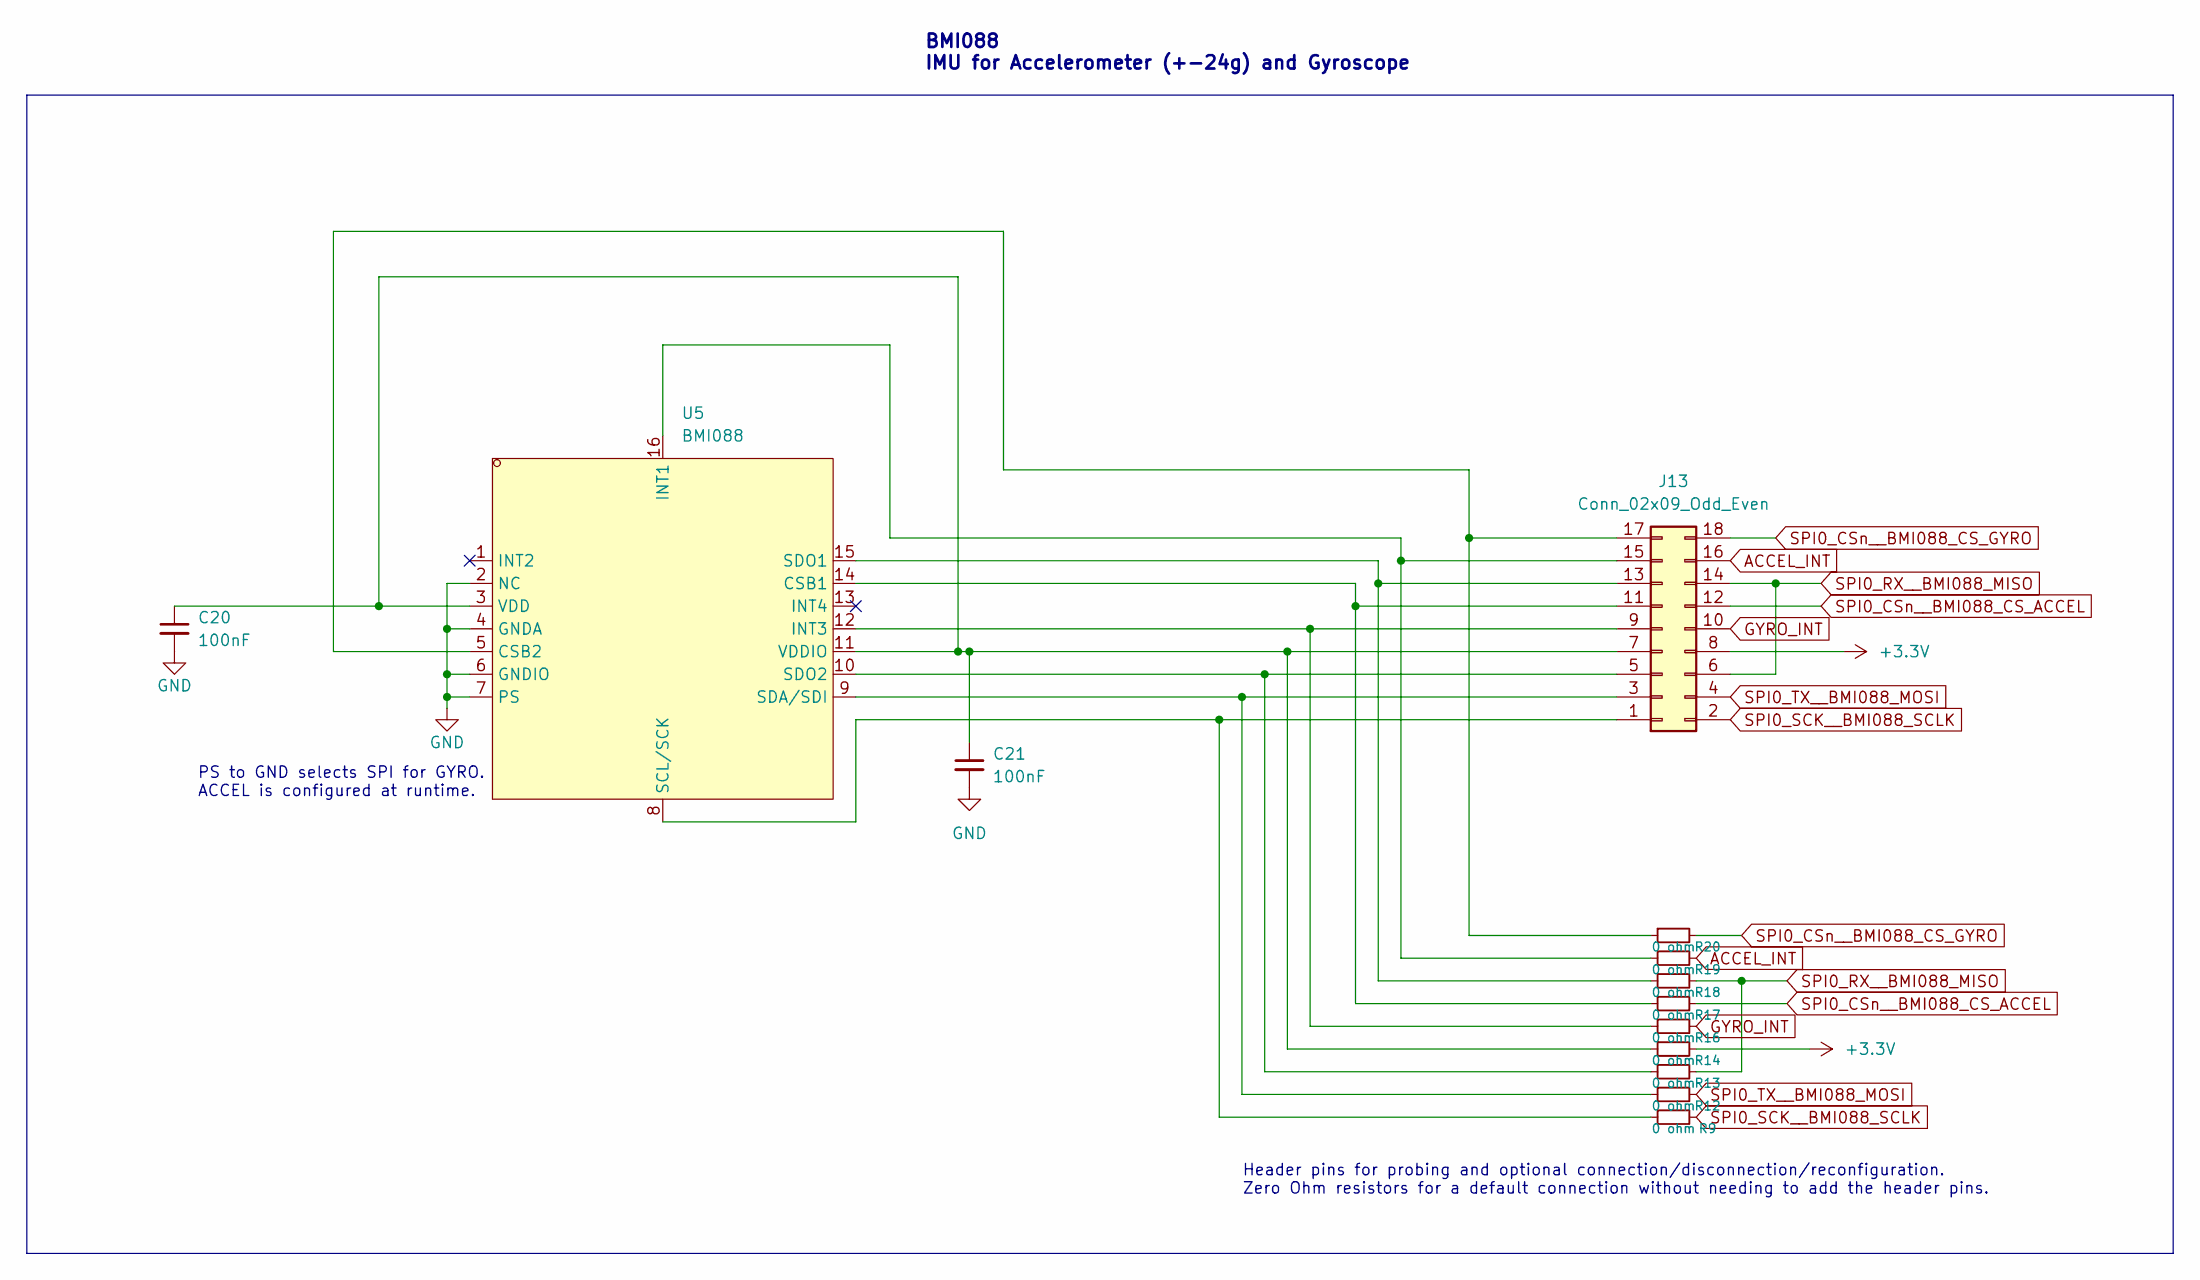
[picture p23: schematic IMU.kicad_sch, IMU - Accelerometer and Gyrocope]

Parts:
C20, C21: 100nF; C_0402_1005Metric; LCSC Part C307331
J13: Conn_02x09_Odd_Even; PinHeader_2x09_P2.54mm_Vertical
R9, R12, R13, R14, R16, R17, R18, R19, R20: 0 ohm; R_0402_1005Metric; LCSC Part C17168
U5: BMI088; LGA-16_L4.5-W3.0-P0.50-BL; LCSC Part C194919

Connections:
+3.3V: J13.8, R14.2; also elsewhere on the board
ACCEL_INT: J13.16, R19.2; also elsewhere on the board
GND: C20.2, C21.2, U5.2 (NC), U5.4 (GNDA), U5.6 (GNDIO), U5.7 (PS); also elsewhere on the board
GYRO_INT: J13.10, R16.2; also elsewhere on the board
unnamed: C20.1, C21.1, J13.7, R14.1, U5.3 (VDD), U5.11 (VDDIO)
unnamed: J13.1, R9.1, U5.8 (SCL/SCK)
unnamed: J13.3, R12.1, U5.9 (SDA/SDI)
unnamed: J13.5, R13.1, U5.10 (SDO2)
unnamed: J13.9, R16.1, U5.12 (INT3)
unnamed: J13.11, R17.1, U5.14 (CSB1)
unnamed: J13.13, R18.1, U5.15 (SDO1)
unnamed: J13.15, R19.1, U5.16 (INT1)
unnamed: J13.17, R20.1, U5.5 (CSB2)
SPI0_CSn__BMI088_CS_ACCEL: J13.12, R17.2; also elsewhere on the board
SPI0_CSn__BMI088_CS_GYRO: J13.18, R20.2; also elsewhere on the board
SPI0_RX__BMI088_MISO: J13.6, J13.14, R13.2, R18.2; also elsewhere on the board
SPI0_SCK__BMI088_SCLK: J13.2, R9.2; also elsewhere on the board
SPI0_TX__BMI088_MOSI: J13.4, R12.2; also elsewhere on the board

Notes on the sheet:
PS to GND selects SPI for GYRO. ACCEL is configured at runtime.
Header pins for probing and optional connection/disconnection/reconfiguration. Zero Ohm resistors for a default connection without needing to add the header pins.
BMI088 IMU for Accelerometer (+-24g) and Gyroscope

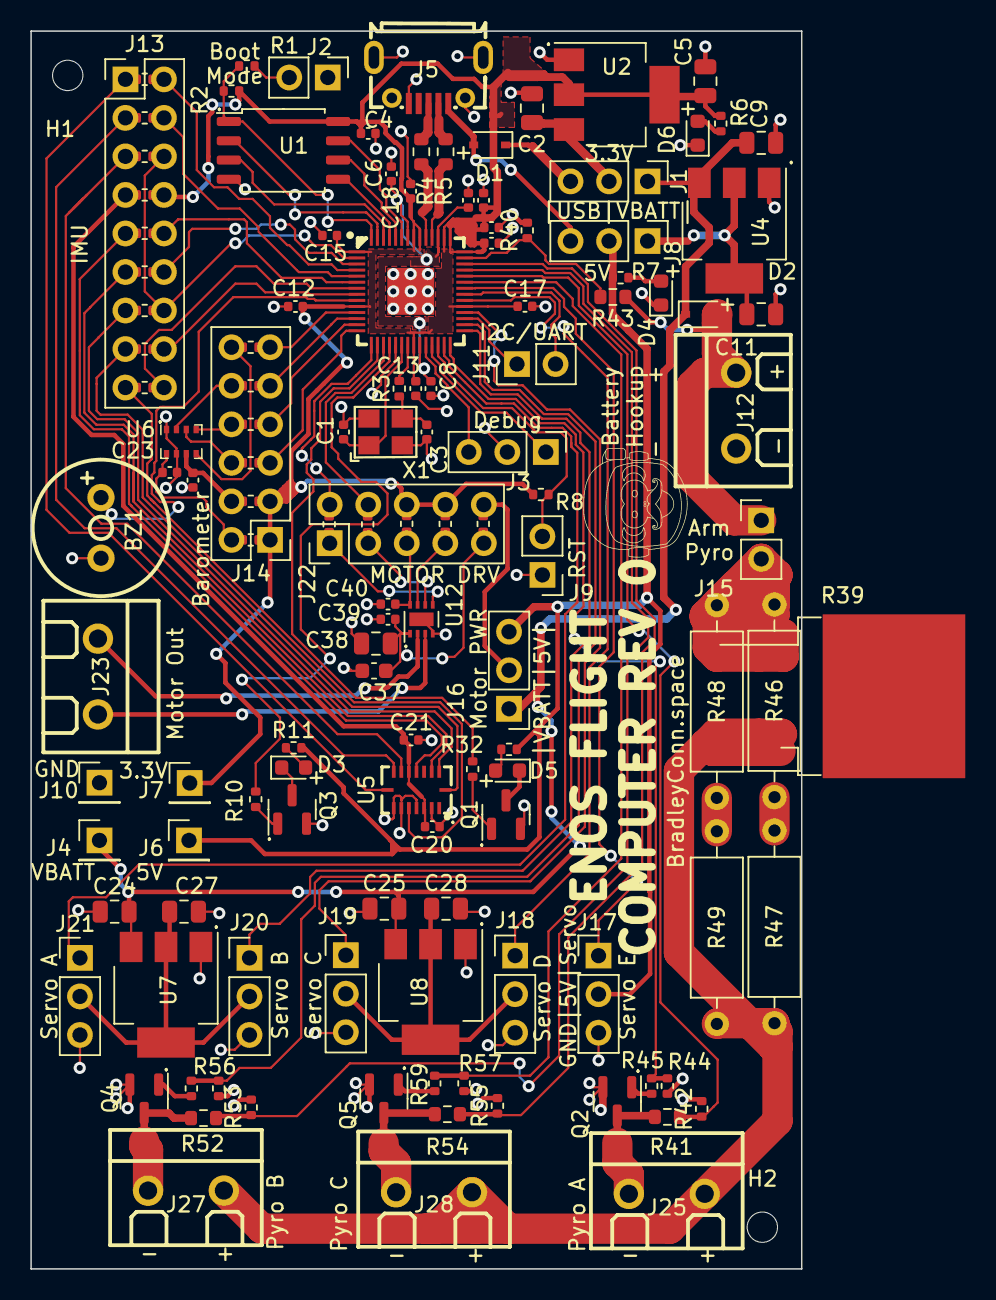
[picture p24: board rp2040_v0.kicad_pcb from above]

Board: 2 copper layers, 50.8 x 81.6 mm, 131 parts (0 on the bottom side), 100 nets.
