BradleyConn/bc_flight_computer/Software/flight_software/src/system/inc/time_keeper.h

#ifndef TIME_KEEPER_H
#define TIME_KEEPER_H

#include <stdint.h>

class TimeKeeper
{
public:
    TimeKeeper();
    bool isValid() const;
    void mark();
    uint64_t deltaTime_us() const;
    uint64_t deltaTime_ms() const;
    uint64_t deltaTime_s() const;
    void printTimeuS() const;
    void printTimeMS() const;
    void printTimeS() const;

    static uint64_t getAbsoluteTime_us();

private:
    uint64_t markTime;
    bool valid;
};

#endif // TIME_KEEPER_H
