BradleyConn/bc_flight_computer/(commit log)

2023-01-29 Add lcsc symbols and footprints
2023-01-29 Add schematic and gitignore file
    [5v_power.kicad_sch, Barometer.kicad_sch, LEDs_and_buzzer.kicad_sch, Servos.kicad_sch, pyro_channels.kicad_sch, reaction_control_wheel.kicad_sch, rp2040_v0.kicad_pcb, rp2040_v0.kicad_sch]
2023-01-29 Fix some wrong schematic footprints.
    [LEDs_and_buzzer.kicad_sch, rp2040_v0.kicad_sch]
2023-01-29 PCB is WAY too big. Start optimizing and update to v0.1.
    Removes reset push button
    [Barometer.kicad_sch, IMU.kicad_sch, LEDs_and_buzzer.kicad_sch, Servos.kicad_sch, pyro_channels.kicad_sch, reaction_control_wheel.kicad_sch, rp2040_v0.kicad_sch]
2023-01-29 Remove level shifter from design
    [Servos.kicad_sch, rp2040_v0.kicad_sch]
2023-01-29 Make the IMU header smaller
    [IMU.kicad_sch, rp2040_v0.kicad_sch]
2023-01-29 Change arming screw terminal to jumper
    [pyro_channels.kicad_sch, rp2040_v0.kicad_sch]
2023-01-29 Remove pyro channel D
    [pyro_channels.kicad_sch, rp2040_v0.kicad_sch]
2023-01-29 Remove telelmetry screw terminal - leave header pin
    [rp2040_v0.kicad_sch]
2023-01-30 Add new smaller red led part
2023-01-30 Swap out ws2812b led for small red and green led.
    [LEDs_and_buzzer.kicad_sch, rp2040_v0.kicad_sch]
2023-01-30 Make mounting holes smaller. Remove and combine extra power headers
    [rp2040_v0.kicad_sch]
2023-01-30 Somehow the power rail led indicator got changed to 5v. Change it back
    [rp2040_v0.kicad_sch]
2023-01-30 Remove extra servo LDO. Nothing else is on that 5V rail so share the normal one.
    [LEDs_and_buzzer.kicad_sch, Servos.kicad_sch, rp2040_v0.kicad_sch]
2023-01-30 Remove flash spi testpoints. They're pretty big by default.
    [rp2040_v0.kicad_sch]
2023-01-30 put power pins on separate headers so you can't accidently attache a jumper and short things.
    [rp2040_v0.kicad_sch]
2023-01-30 Remove reaction wheel LDO. Add jumper to select power source.
    [LEDs_and_buzzer.kicad_sch, Servos.kicad_sch, reaction_control_wheel.kicad_sch, rp2040_v0.kicad_sch]
2023-01-30 Initial unrouted pcb layout
    [rp2040_v0.kicad_pcb]
2023-01-30 Remove -Batt and just call it GND so it's less confusing in PCB
    [rp2040_v0.kicad_sch]
2023-01-30 Update the flash chip footprint to use default kicad instead of generated one. The 3d model was messed up and I wanted assurance the footprint was not the issue.
    [rp2040_v0.kicad_sch]
2023-01-30 Change net from global to net so it didn't change the name in pcb
    [Servos.kicad_sch]
2023-01-30 CRITICAL MISTAKE FOUND. FIXED. Flash was wired wrong. Add versioning sheet.
    [rp2040_v0.kicad_sch, version_notes.kicad_sch]
2023-01-30 Update sheets to say V0.2.
    [Barometer.kicad_sch, IMU.kicad_sch, LEDs_and_buzzer.kicad_sch, Servos.kicad_sch, pyro_channels.kicad_sch, reaction_control_wheel.kicad_sch]
2023-01-30 Change LEDs to be kicad versions using kicad footprints for consistancy.
    [IMU.kicad_sch, LEDs_and_buzzer.kicad_sch, rp2040_v0.kicad_sch]
2023-01-30 Update leds and further layout work
    [rp2040_v0.kicad_pcb]
2023-01-30 Change connector to be odd-even
    [Servos.kicad_sch]
2023-01-30 Add note on raw usb power to schematic
    [rp2040_v0.kicad_sch]
2023-01-30 witch led and pyro pins for easier routing
    [rp2040_v0.kicad_sch]
2023-01-30 update pcb with new pinout
    [rp2040_v0.kicad_pcb]
2023-01-31 Change some header pin pinouts to make routing easier.
    [Barometer.kicad_sch, IMU.kicad_sch]
2023-01-31 Whoops - reconnect IMU pin that accidently got removed.
    [IMU.kicad_sch]
2023-01-31 MAKE SURE SAFTEY ARMING JUMPER IS BEFORE THE RESISTORS. Don't leave any hot wires exposed.
    [pyro_channels.kicad_sch]
2023-01-31 Add net name to other side of temrination resistors for usb so it's easier to see in pcb.
    [rp2040_v0.kicad_sch]
2023-01-31 Moved reaction control wheel pin numbers around for easier routing.
    [reaction_control_wheel.kicad_sch]
2023-01-31 ON NO! I didn't realize the IMU is not in the center of the board and it really ought to be. What to do what to do...
    [rp2040_v0.kicad_pcb]
2023-01-31 Update files to v0.3 and add new notes to version sheet.
    [Barometer.kicad_sch, IMU.kicad_sch, LEDs_and_buzzer.kicad_sch, Servos.kicad_sch, pyro_channels.kicad_sch, reaction_control_wheel.kicad_sch, rp2040_v0.kicad_sch, version_notes.kicad_sch]
2023-02-22 Rev 0 ready to ship! Had to move IMU so board got sloppy. IMU should be in the middle of the board. Glad I caught that.
    [Barometer.kicad_sch, IMU.kicad_sch, LEDs_and_buzzer.kicad_sch, Servos.kicad_sch, pyro_channels.kicad_sch, reaction_control_wheel.kicad_sch, rp2040_v0.kicad_pcb, rp2040_v0.kicad_sch]
2023-02-23 Some minor changes with footprint. Sent to JLCPCB. Official Rev 0!
    [Barometer.kicad_sch, IMU.kicad_sch, LEDs_and_buzzer.kicad_sch, Servos.kicad_sch, pyro_channels.kicad_sch, reaction_control_wheel.kicad_sch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]
2023-03-07 Add pico-sdk submodule
2023-04-21 Move the plus minus silkscreen on the bottom back into place.
    [rp2040_v0.kicad_pcb]
2023-05-10 PID fixes
2023-05-10 Copy of pico examples setup with hello_world
2023-05-11 Prototyping pwm servo and led fades
2023-05-12 Servo drivers added
2023-05-13 add pwm_led driver
2023-05-15 Update pwm drivers to get channels by function using pins instead of params.
2023-05-16 Add BMP280 driver
2023-08-20 First pass working accel. Maybe Gyro too. Accel needed a dummy byte read.
2023-09-12 Added 3d model folder. Most models are still missing
    [24mm_to_29mm_adapter.scad, 24mm_to_29mm_adapter.stl, board_monut_board_slot_test.scad, board_monut_board_slot_test.stl]
2023-12-16 Use bsp file defines for BMP and BMI sensors.
2023-12-16 Add range and bandwith to gyro init
2023-12-16 Change the digital servo speed to something appropriate - untested.
2023-12-17 Turn printing into helper functions in bmi088
2023-12-18 Overhaul the bmi088 driver. Basically like new. Can read all registers and calulate values and print them.
2023-12-19 Fix type compare warnings
    [drv_bmi088.cpp]
2023-12-19 Add comment to the top of the BMI088 driver. Remove commented out code
2023-12-21 Update bmp280 driver. Remove humidty, and use style of bmi088
2023-12-22 Add thrust curve lookup of e12, and timekeeper classes
2023-12-22 Add buzzer driver
2024-01-08 Add a flash logging driver.
2024-01-08 Add data container to store and print all telemetery
2024-01-08 Store telem in flash. Read it back next boot and print it with telem print functions.
2024-01-10 Move thrust curves to their own folder.
2024-01-17 Remove BMP delay and add/delete some comments. Add function to turn of servo.
2024-01-17 Add E9 thrust curve.
2024-01-17 Add gpio driver.
2024-01-17 Add a servo characterization test
2024-01-21 Update bmi driver to use interrupt signals for proper data frequency. Update data rates
2024-01-21 Add orientation tests - dc bias is a thing with gyros. who knew
2024-01-21 Add calibration into the gyro driver
2024-01-30 AYYYY I KNOW THE ORIENTATION ROLL-PITCH-ROLL CALCULATION WORKS!!
2024-02-10 Add some wip baseline pressure stuff
2024-02-15 Add printing via usb
2024-02-16 Update the servo drivers to be the correct range... Add an integated offset
    [drv_servo.cpp, drv_servo.h]
2024-02-16 Make gyro calibration one variable
2024-02-16 Fix a bug in the gyro calibration that I just introduced
    [drv_bmi088.cpp, drv_bmi088.h]
2024-02-16 Remove printing in servo and format it.
2024-02-20 Make torque to tvc angle float instead of int
2024-02-20 Add blocking play sounds in buzzer.
    [drv_buzzer.cpp, drv_buzzer.h, main.cpp]
2024-02-22 Not tuned correctly I'm sure but should be a working conrtol loop
    [control_loop.cpp, control_loop.h, drv_buzzer.cpp, main.cpp, orientation_calculator.cpp, state_detector.cpp, state_detector.h]
